Wacetub/LoRa-MultiScene-System/code/LoraC8T6鍓妭2鏈_SYS/my_usart1.c

/****************
1、串口时钟、GPIOA时钟使能
2、GPIOA端口模式设置
3、串口参数初始化
4、开启中断并且初始化NVIC
5、使能串口
6、编写中断处理函数
******************/
#include "sys.h"  //包含需要的头文件

void My_USART1(void)
{
	
	GPIO_InitTypeDef GPIO_InitStruct;
	USART_InitTypeDef USART1_InitStrue;
	NVIC_InitTypeDef NVIC_InitStructure;
	//1、串口时钟、GPIOA时钟使能
	RCC_APB2PeriphClockCmd(RCC_APB2Periph_GPIOA|RCC_APB2Periph_USART1, ENABLE);
	
	//2、GPIOA端口模式设置
	GPIO_InitStruct.GPIO_Pin = USART1_GPIO_PIN_TX;//PA9
	GPIO_InitStruct.GPIO_Mode = GPIO_Mode_AF_PP;
	GPIO_InitStruct.GPIO_Speed = GPIO_Speed_50MHz;	
	GPIO_Init(GPIOA, &GPIO_InitStruct);
	
	GPIO_InitStruct.GPIO_Pin = USART1_GPIO_PIN_RX;//PA10
	GPIO_InitStruct.GPIO_Mode = GPIO_Mode_IN_FLOATING;
	//GPIO_InitStruct.GPIO_Speed = GPIO_Speed_50MHz;	
	GPIO_Init(GPIOA, &GPIO_InitStruct);	
	
	//3、串口参数初始化
	
	USART1_InitStrue.USART_BaudRate = 115200;
	USART1_InitStrue.USART_HardwareFlowControl = USART_HardwareFlowControl_None;
	USART1_InitStrue.USART_Mode = USART_Mode_Rx|USART_Mode_Tx;
	USART1_InitStrue.USART_Parity = USART_Parity_No;
	USART1_InitStrue.USART_StopBits=USART_StopBits_1;
	USART1_InitStrue.USART_WordLength = USART_WordLength_8b;
	
	USART_Init( USART1, &USART1_InitStrue);
	//4、开启中断并且初始化NVIC
	USART_ITConfig(USART1, USART_IT_RXNE, ENABLE);
	NVIC_InitStructure.NVIC_IRQChannel =USART1_IRQn ;
	NVIC_InitStructure.NVIC_IRQChannelPreemptionPriority = 3; 
	NVIC_InitStructure.NVIC_IRQChannelSubPriority = 3;
	NVIC_InitStructure.NVIC_IRQChannelCmd= ENABLE;
	NVIC_Init(&NVIC_InitStructure);
	
	//5、使能串口
	USART_Cmd(USART1,ENABLE);
	
	//6、编写中断处理函数	
	
}

void USART_SendByte(USART_TypeDef* USARTx, uint16_t Data)
{
  /* Check the parameters */
  assert_param(IS_USART_ALL_PERIPH(USARTx));
  assert_param(IS_USART_DATA(Data)); 
    
  /* Transmit Data */
  USARTx->DR = (Data & (uint16_t)0x01FF);
  while (USART_GetFlagStatus(USARTx, USART_FLAG_TXE) == RESET);

}

void USART_SendString( USART_TypeDef * USARTx, char *str)
{
     while(*str!='\0')
     {
         USART_SendByte( USARTx, *str++ );	
     }
     while(USART_GetFlagStatus(USARTx,USART_FLAG_TC)==RESET);
}
uint8_t USART_ReceiveByte(USART_TypeDef* USARTx)
{
  while(USART_GetFlagStatus(USARTx,USART_FLAG_RXNE)==RESET);
  
  return (uint8_t)USART_ReceiveData(USART1);

}

void USART1_IRQHandler()
{
	u8 temp;
//	while(USART_GetITStatus(USART1,USART_IT_RXNE) == RESET);
	if(USART_GetITStatus(USART1,USART_IT_RXNE) != RESET)
	{
		temp = USART_ReceiveData(USART1);
		
	}
	
	USART_SendByte(USART1,temp);	

}
//#pragma import(__use_no_semihosting)             
//                 
//struct __FILE 
//{ 
//	int handle; 

//}; 

//FILE __stdout;          
//_sys_exit(int x) 
//{ 
//	x = x; 
//} 

int fputc(int ch, FILE *f)
{
		
		USART_SendData(USART1, (uint8_t) ch);			
		while (USART_GetFlagStatus(USART1, USART_FLAG_TXE) == RESET);			
		return (ch);
}


int fgetc(FILE *f)
{		
		while (USART_GetFlagStatus(USART1, USART_FLAG_RXNE) == RESET);
		return (int)USART_ReceiveData(USART1);
}
