Wacetub/LoRa-MultiScene-System/code/LoraC8T6鍓妭2鏈_SYS/time3.c

#include "sys.h"
/********************
①使能定时器时钟。
RCC_APB1PeriphClockCmd();
② 初始化定时器，配置ARR,PSC。
TIM_TimeBaseInit();
③定时器中断配置，同时配置NVIC。
void TIM_ITConfig();
NVIC_Init();
④使能定时器。
TIM_Cmd();
⑤编写中断服务函数。
TIMx_IRQHandler();
*****************/

extern vu16 USART3_RX_STA;

void TIM3_Init(u16 arr,u16 psc)
{
	TIM_TimeBaseInitTypeDef TIM_TimeBaseStructure;
	NVIC_InitTypeDef NVIC_InitStruct;
	RCC_APB1PeriphClockCmd(RCC_APB1Periph_TIM3,ENABLE);
	
	TIM_TimeBaseStructure.TIM_Period = arr;
	TIM_TimeBaseStructure.TIM_Prescaler = psc;
	TIM_TimeBaseStructure.TIM_ClockDivision = 0;
	TIM_TimeBaseStructure.TIM_CounterMode = TIM_CounterMode_Up;
	TIM_TimeBaseInit(TIM3,&TIM_TimeBaseStructure);
	
	TIM_ITConfig(TIM3, TIM_IT_Update, ENABLE);
	
	NVIC_InitStruct.NVIC_IRQChannel = TIM3_IRQn;
	NVIC_InitStruct.NVIC_IRQChannelPreemptionPriority = 0;
	NVIC_InitStruct.NVIC_IRQChannelSubPriority = 2;
	NVIC_InitStruct.NVIC_IRQChannelCmd = ENABLE;
	
	NVIC_Init(&NVIC_InitStruct);
	TIM_Cmd(TIM3, ENABLE);
}

void TIM3_IRQHandler(void)
{
	if (TIM_GetITStatus(TIM3, TIM_IT_Update) != RESET) //检查指定的TIM中断发生与否:TIM 中断源 
		{
			TIM_ClearITPendingBit(TIM3, TIM_IT_Update);  //清除TIMx的中断待处理位:TIM 中断源 
			
			USART3_RX_STA|=1<<15;	 //标记接收完成
			TIM_Cmd(TIM3, DISABLE); //关闭TIM3 
		}

}
