Wacetub/LoRa-MultiScene-System/code/LoraC8T6鍓妭2鏈_SYS/usart3.h

#ifndef __USART3_H
#define __USART3_H
#include "sys.h"

#define USART3_MAX_RECV_LEN		1024			    //最大接收缓存字节数
#define USART3_MAX_SEND_LEN		600					//最大发送缓存字节数
#define USART3_RX_EN 			1					//0,不接收;1,接收.

extern u8  USART3_RX_BUF[USART3_MAX_RECV_LEN]; 		//接收缓冲,最大USART3_MAX_RECV_LEN字节
extern u8  USART3_TX_BUF[USART3_MAX_SEND_LEN]; 		//发送缓冲,最大USART3_MAX_SEND_LEN字节
extern vu16 USART3_RX_STA;   						//接收数据状态

void usart3_init(u32 bound);		//串口2初始化 
void usart3_set(u8 bps,u8 parity);    
void usart3_rx(u8 enable);
void u3_printf(char* fmt,...);

#endif
