Wacetub/LoRa-MultiScene-System/(commit log)

2026-10-25 init: 初始化仓库
2026-10-25 feat: LoRa 多场景信息采集系统（网关 + 两个终端节点 + 设计文档）
    - 网关：STM32F103ZET6，LoRa 定向帧轮询 A/B 节点
    - 节点：STM32F103C8T6，RS485 Modbus RTU 采集温湿度/氮磷钾/pH
    - 文档：完整版与精简版设计文档
