Wacetub/LoRa-MultiScene-System/(notices)

Notices in the files:
code/LoraZET6涓昏妭鐐圭Щ妞_User/rs485.c:
Copyright(C) ¹ãÖÝÊÐÐÇÒíµç×Ó¿Æ¼¼ÓÐÏÞ¹«Ë¾ 2009-2019
All rights reserved
